pauloone/Krabi-PAMI/Board/PAMI.kicad_pcb

## KiCad design Board/PAMI.kicad_pcb (2023-10-10)

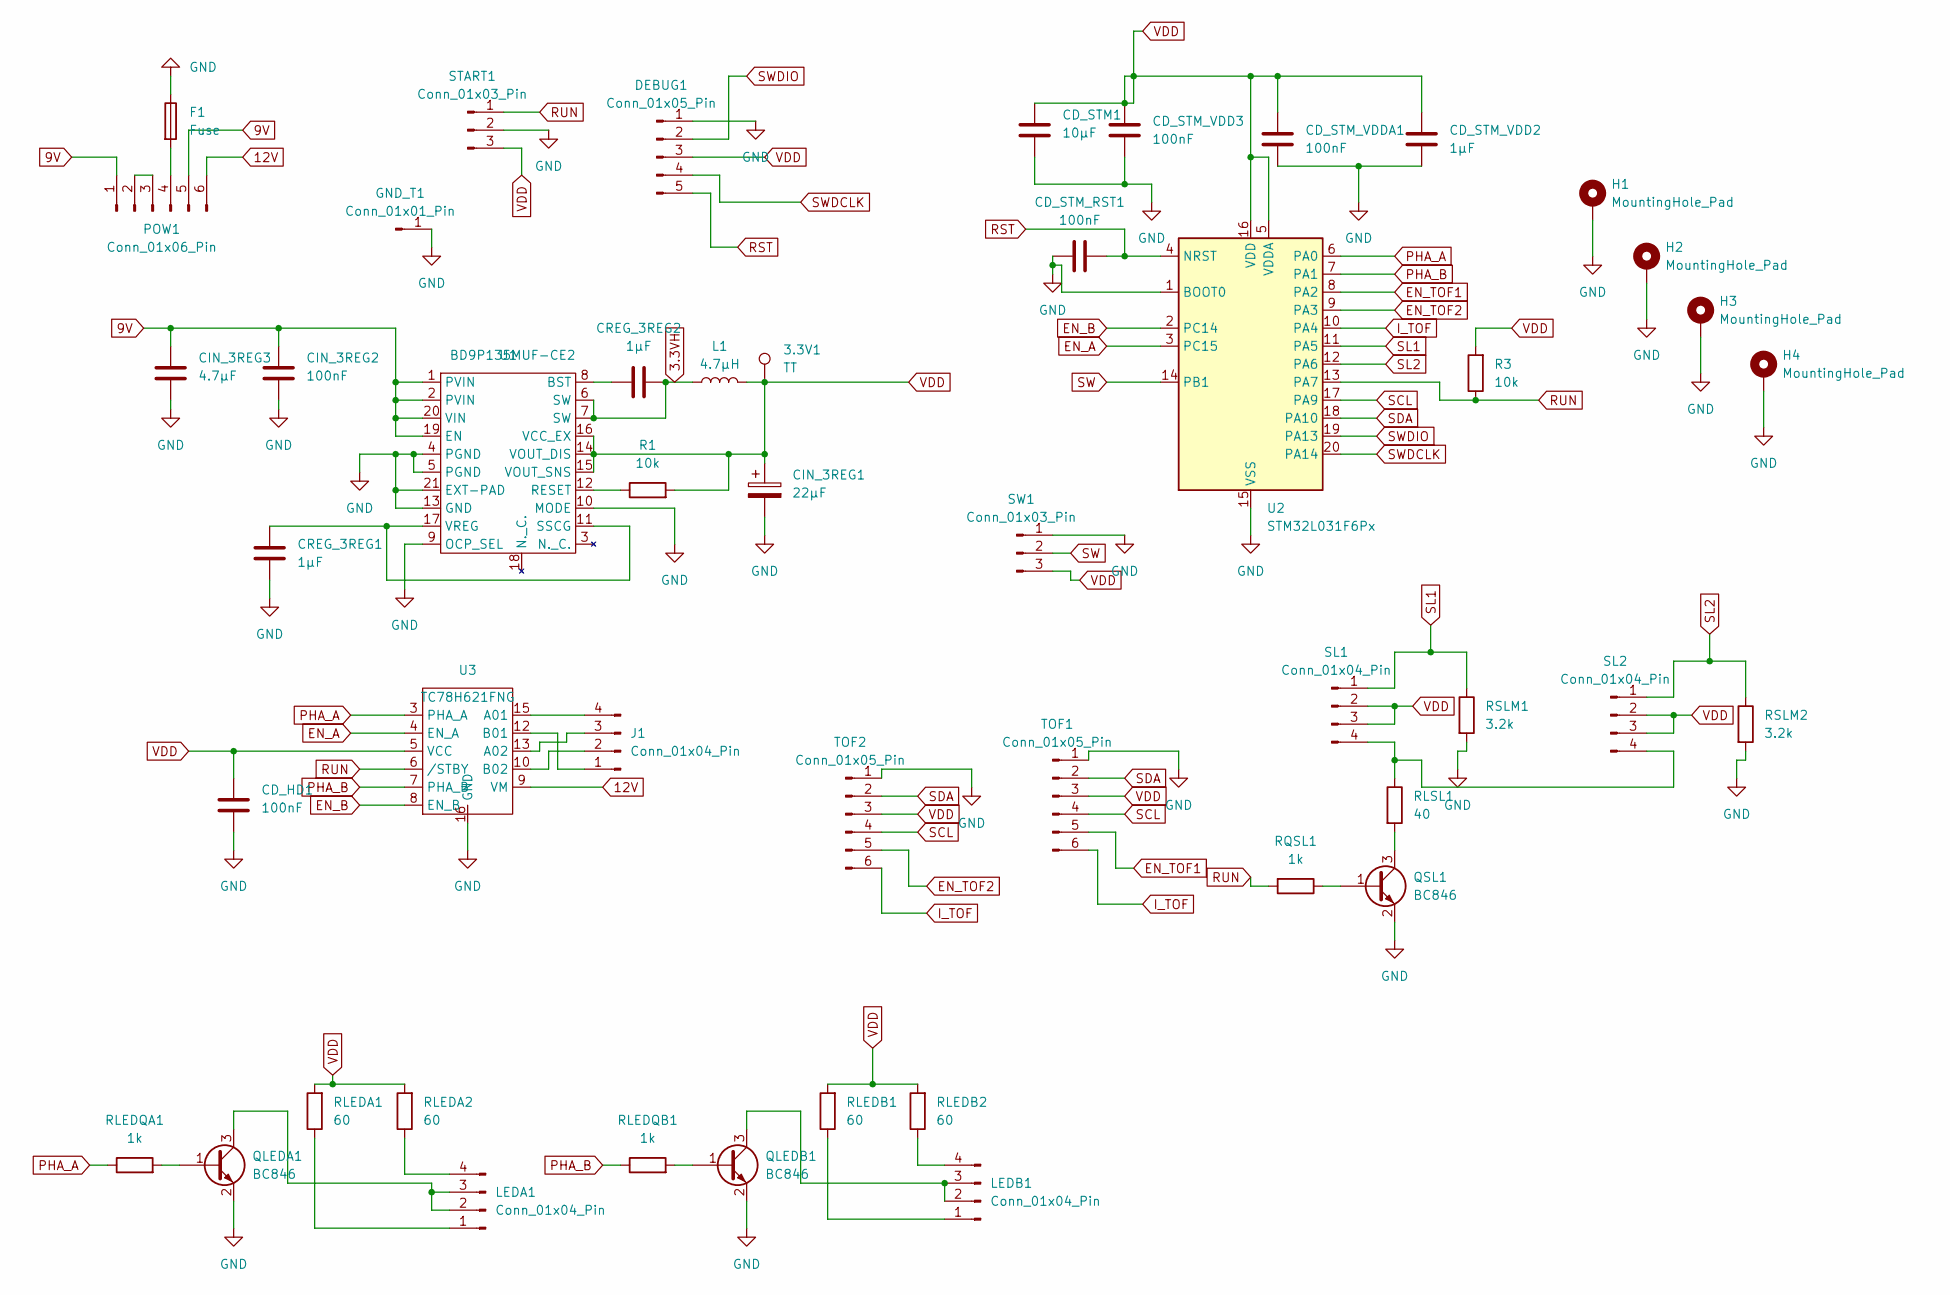
[picture p1: schematic PAMI.kicad_sch]

Parts:
3.3V1: TT; TestPoint_Pad_D1.0mm
CD_HD1: 100nF; C_0603_1608Metric
CD_STM1: 10µF; C_0805_2012Metric
CD_STM_RST1: 100nF; C_0603_1608Metric
CD_STM_VDD2: 1µF; C_0603_1608Metric
CD_STM_VDD3: 100nF; C_0603_1608Metric
CD_STM_VDDA1: 100nF; C_0603_1608Metric
CIN_3REG1: 22µF; CP_EIA-3528-21_Kemet-B
CIN_3REG2: 100nF; C_0603_1608Metric
CIN_3REG3: 4.7µF; C_0805_2012Metric
CREG_3REG1, CREG_3REG2: 1µF; C_0603_1608Metric
DEBUG1: Conn_01x05_Pin; PinHeader_1x05_P1.00mm_Vertical
F1: Fuse; Fuse_1206_3216Metric
GND_T1: Conn_01x01_Pin; Pin_D0.7mm_L6.5mm_W1.8mm_FlatFork
H1, H2, H3, H4: MountingHole_Pad; MountingHole_2.2mm_M2_Pad
J1: Conn_01x04_Pin; SolderWire-0.5sqmm_1x04_P4.6mm_D0.9mm_OD2.1mm
L1: 4.7µH; L_1008_2520Metric
LEDA1: Conn_01x04_Pin; PinHeader_1x04_P1.00mm_Vertical
LEDB1: Conn_01x04_Pin; PinHeader_1x04_P1.00mm_Vertical
POW1: Conn_01x06_Pin; SolderWire-0.5sqmm_1x06_P4.6mm_D0.9mm_OD2.1mm
QLEDA1: BC846; SOT-23
QLEDB1: BC846; SOT-23
QSL1: BC846; SOT-23
R1, R3: 10k; R_0603_1608Metric
RLEDA1, RLEDA2: 60; R_0603_1608Metric
RLEDB1, RLEDB2: 60; R_0603_1608Metric
RLEDQA1: 1k; R_0603_1608Metric
RLEDQB1: 1k; R_0603_1608Metric
RLSL1: 40; R_0603_1608Metric
RQSL1: 1k; R_0603_1608Metric
RSLM1, RSLM2: 3.2k; R_0603_1608Metric
SL1, SL2: Conn_01x04_Pin; PinHeader_1x04_P1.00mm_Vertical
START1: Conn_01x03_Pin; PinHeader_1x03_P1.00mm_Vertical
SW1: Conn_01x03_Pin; PinHeader_1x03_P1.00mm_Vertical
TOF1, TOF2: Conn_01x05_Pin; PinHeader_1x06_P1.00mm_Vertical
U1: BD9P135MUF-CE2; VQFN20FV4040
U2: STM32L031F6Px; TSSOP-20_4.4x6.5mm_P0.65mm
U3: TC78H621FNG; TSSOP-16_4.4x5mm_P0.65mm

Connections:
3.3VH: CREG_3REG2.2, L1.1, U1.6 (SW), U1.7 (SW)
9V: CIN_3REG2.1, CIN_3REG3.1, POW1.1, POW1.5, U1.1 (PVIN), U1.2 (PVIN), U1.19 (EN), U1.20 (VIN)
12V: POW1.6, U3.9 (VM)
EN_A: U2.3 (PC15), U3.4 (EN_A)
EN_B: U2.2 (PC14), U3.8 (EN_B)
EN_TOF1: TOF1.5, U2.8 (PA2)
EN_TOF2: TOF2.5, U2.9 (PA3)
GND: CD_HD1.2, CD_STM1.2, CD_STM_RST1.2, CD_STM_VDD2.1, CD_STM_VDD3.1, CD_STM_VDDA1.1, CIN_3REG1.2, CIN_3REG2.2, CIN_3REG3.2, CREG_3REG1.2, DEBUG1.1, F1.1, GND_T1.1, H1.1, H2.1, H3.1, H4.1, QLEDA1.2 (E), QLEDB1.2 (E), QSL1.2 (E), RSLM1.2, RSLM2.2, START1.2, SW1.1, TOF1.1, TOF2.1, U1.4 (PGND), U1.5 (PGND), U1.9 (OCP_SEL), U1.10 (MODE), U1.13 (GND), U1.21 (EXT-PAD), U2.1 (BOOT0), U2.15 (VSS), U3.11 (GND), U3.14 (GND), U3.16 (GND)
I_TOF: TOF1.6, TOF2.6, U2.10 (PA4)
unnamed: J1.1, U3.12 (B01)
unnamed: J1.2, U3.10 (B02)
unnamed: J1.3, U3.13 (A02)
unnamed: J1.4, U3.15 (A01)
unnamed: LEDA1.1, RLEDA1.1
unnamed: LEDA1.2, LEDA1.3, QLEDA1.3 (C)
unnamed: LEDA1.4, RLEDA2.1
unnamed: LEDB1.1, RLEDB1.1
unnamed: LEDB1.2, LEDB1.3, QLEDB1.3 (C)
unnamed: LEDB1.4, RLEDB2.1
unnamed: POW1.2, POW1.3
unnamed: F1.2, POW1.4
unnamed: QLEDA1.1 (B), RLEDQA1.2
unnamed: QLEDB1.1 (B), RLEDQB1.2
unnamed: QSL1.1 (B), RQSL1.1
unnamed: QSL1.3 (C), RLSL1.2
unnamed: RLSL1.1, SL1.4, SL2.4
unnamed: CREG_3REG2.1, U1.8 (BST)
unnamed: R1.1, U1.12 (RESET)
unnamed: CREG_3REG1.1, U1.11 (SSCG), U1.17 (VREG)
PHA_A: RLEDQA1.1, U2.6 (PA0), U3.3 (PHA_A)
PHA_B: RLEDQB1.1, U2.7 (PA1), U3.7 (PHA_B)
RST: CD_STM_RST1.1, DEBUG1.5, U2.4 (NRST)
RUN: R3.1, RQSL1.2, START1.1, U2.13 (PA7), U3.6 (/STBY)
SCL: TOF1.4, TOF2.4, U2.17 (PA9)
SDA: TOF1.2, TOF2.2, U2.18 (PA10)
SL1: RSLM1.1, SL1.1, U2.11 (PA5)
SL2: RSLM2.1, SL2.1, U2.12 (PA6)
SW: SW1.2, U2.14 (PB1)
SWDCLK: DEBUG1.4, U2.20 (PA14)
SWDIO: DEBUG1.2, U2.19 (PA13)
VDD: 3.3V1.1, CD_HD1.1, CD_STM1.1, CD_STM_VDD2.2, CD_STM_VDD3.2, CD_STM_VDDA1.2, CIN_3REG1.1, DEBUG1.3, L1.2, R1.2, R3.2, RLEDA1.2, RLEDA2.2, RLEDB1.2, RLEDB2.2, SL1.2, SL1.3, SL2.2, SL2.3, START1.3, SW1.3, TOF1.3, TOF2.3, U1.14 (VOUT_DIS), U1.15 (VOUT_SNS), U1.16 (VCC_EX), U2.5 (VDDA), U2.16 (VDD), U3.5 (VCC)

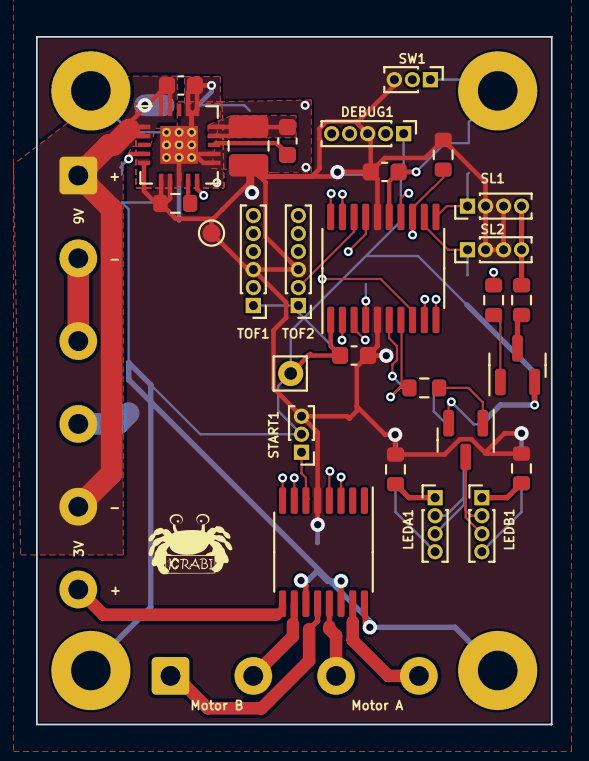
[picture p2: board PAMI.kicad_pcb from above]

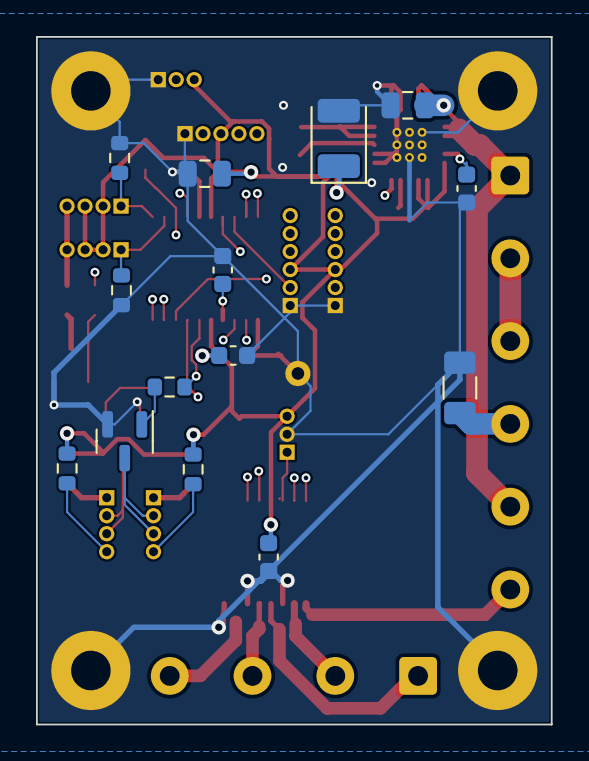
[picture p3: board PAMI.kicad_pcb from below]

Board: 4 copper layers, 28.6 x 38.2 mm, 48 parts (14 on the bottom side), 41 nets.
