pauloone/Krabi-PAMI/beetlebrain/beetlebrain/Core/Src/main.c

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
/* Includes ------------------------------------------------------------------*/
#include "main.h"
//#include "VL53L0X.h"

ADC_HandleTypeDef hadc;
DMA_HandleTypeDef hdma_adc;

I2C_HandleTypeDef hi2c1;
DMA_HandleTypeDef hdma_i2c1_rx;
DMA_HandleTypeDef hdma_i2c1_tx;

RTC_HandleTypeDef hrtc;

TIM_HandleTypeDef htim2;

/* USER CODE BEGIN PV */

const volatile adc_values_type adc_values;
const uint16_t	i2c_dev_address= 0x52;
uint16_t *adc_value_pointer;
uint16_t *other_adc_value_pointer;
uint16_t error_direction = 1; // this is 1 or minus one, and define if we follow the left or right side
uint32_t adc_interrupt_counter = 0;

/* USER CODE END PV */

void SystemClock_Config(void);
static void MX_GPIO_Init(void);
static void MX_DMA_Init(void);
static void MX_ADC_Init(void);
static void MX_I2C1_Init(void);
static void MX_TIM2_Init(void);
static void MX_RTC_Init(void);
/* USER CODE BEGIN 0 */
volatile uint16_t pwm1 = 100;
volatile uint16_t pwm2 = 100;
/* USER CODE END 0 */

/**
  * @brief  The application entry point.
  * @retval int
  */
int main(void)
{
  /* MCU Configuration--------------------------------------------------------*/

  /* Reset of all peripherals, Initializes the Flash interface and the Systick. */


	HAL_Init();
  //SET_BIT(RCC->APB1ENR, (RCC_APB1ENR_TIM2EN));

  /* Configure the system clock */
  SystemClock_Config();

  /* Initialize all configured peripherals */
  MX_GPIO_Init();
  MX_DMA_Init();
  MX_ADC_Init();
  MX_I2C1_Init();
  MX_TIM2_Init();

  /* USER CODE BEGIN 2 */

  //interrupt_init();

  if (HAL_ADC_Start_DMA(&hadc, &adc_values.dma_pointer, 4) != HAL_OK)
  {
    Error_Handler();
  }

  adc_value_pointer = &adc_values.adc_values[0];
  other_adc_value_pointer = &adc_values.adc_values[1];

  /* USER CODE END 2 */

  TIM2->CCR1 = PWM_PERIOD/2;
  TIM2->CCR2  = PWM_PERIOD/2;

  //HAL_GPIO_WritePin(GPIOC, EN_TOF2_Pin|EN_TOF1_Pin, GPIO_PIN_SET);
//  initVL53L0X(0);
//  HAL_Delay(2);
//  setMeasurementTimingBudget( 100 * 1000UL );
//  statInfo_t xTraStats;
//  startContinuous(100);
  GPIO_PinState RUN_state =  GPIO_PIN_RESET;
  while(RUN_state == GPIO_PIN_RESET){
	  RUN_state = HAL_GPIO_ReadPin(RUN_GPIO_Port, RUN_Pin);
//		readRangeContinuousMillimeters( &xTraStats );	// blocks until measurement is finished
//		HAL_Delay(2);
  }
  // Start signal

  HAL_Delay(90000);
  /* USER CODE END 3 */
  //Beginning of the PAMI allowed run period
  TIM2->CR1 |= TIM_CR1_CEN;
  HAL_GPIO_WritePin(GPIOC, GPIO_PIN_14|GPIO_PIN_15, GPIO_PIN_SET); // enable motors

  HAL_Delay(10000);
  HAL_GPIO_WritePin(GPIOC, GPIO_PIN_14|GPIO_PIN_15, GPIO_PIN_RESET); // enable motors

  TIM2->CR1 &= !TIM_CR1_CEN;
  HAL_ADC_Stop_DMA(&hadc);
  while(1){
	  asm("NOP");
  }
}

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
