pauloone/Krabi-PAMI/beetlebrain/beetlebrain/beetlebrain.ioc

Mcu.UserName=STM32L031F6Px
PA0-CK_IN.GPIO_Label=PHA_A
PA0-CK_IN.Signal=S_TIM2_CH1
PA1.GPIO_Label=PHA_B
PA1.Signal=S_TIM2_CH2
PA10.Signal=I2C1_SDA
PA13.Signal=SYS_SWDIO
PA14.Signal=SYS_SWCLK
PA2.GPIO_Label=EN_TOF1
PA2.Signal=GPIO_Output
PA3.GPIO_Label=EN_TOF2
PA3.Signal=GPIO_Output
PA4.GPIO_Label=I_OTF
PA4.Signal=GPIO_Input
PA5.Signal=ADC_IN5
PA6.Signal=ADC_IN6
PA7.GPIO_Label=RUN
PA7.Signal=GPXTI7
PA9.Signal=I2C1_SCL
PB1.GPIO_Label=SWITCH
PB1.Signal=GPIO_Input
PC14-OSC32_IN.Signal=GPIO_Output
PC15-OSC32_OUT.Signal=GPIO_Output
