pauloone/Krabi-PAMI/beetlebrain/beetlebrain/Core/Inc/main.h

#define PHA_A_Pin GPIO_PIN_0
#define PHA_A_GPIO_Port GPIOA
#define PHA_B_Pin GPIO_PIN_1
#define PHA_B_GPIO_Port GPIOA
#define EN_TOF1_Pin GPIO_PIN_2
#define EN_TOF1_GPIO_Port GPIOA
#define EN_TOF2_Pin GPIO_PIN_3
#define EN_TOF2_GPIO_Port GPIOA
#define I_OTF_Pin GPIO_PIN_4
#define I_OTF_GPIO_Port GPIOA
#define RUN_Pin GPIO_PIN_7
#define RUN_GPIO_Port GPIOA
#define SWITCH_Pin GPIO_PIN_1
#define SWITCH_GPIO_Port GPIOB
#define PWM_PERIOD 319 // ((32Mhz/50kHz /2) - 1) divided by 2 because up down
#define SENSOR_TARGET 200
#define FORWARD_SPEED 300
#define ADC_TARGET	817
