pauloone/Krabi-PAMI/(commit log)

2023-10-08 Add schematics & PCB design
    [PAMI.kicad_pcb, PAMI.kicad_sch]
2023-10-08 Fix some minor glith on plan & add logo
    [PAMI.kicad_pcb]
2023-10-10 Fix DCR
    [PAMI.kicad_pcb]
2024-04-02 Board update
2024-04-02 Configure RUN pin interrupt
2024-04-02 Register interrupt callback and enable interrupt
2024-04-02 RUN interrupt configured and tested with software trigger
2024-04-02 Calibrate ADC
2024-04-11 Simple PID
2024-05-03 Update WE before coupe
    [PAMI.csv, PAMI.kicad_sch]
2024-05-05 Working PWM
